0x3b29/Bahnhofs-Steuerung-2000/media/Documentation/Memory_Layout_System.pdf

System

Seite 1

Layout | Legend

Bytes
0 1 2 3 4 5 6 7 | 16 | Total bytes in use
0 | 0 | 1 | 2 | 3 | 4 | 5 | 6 | 7 | 2 | Channels
1 | 8 | 9 | 10 | 11 | 12 | 13 | 14 | 15 | 1 | Force all on
2 | 16 | 17 | 18 | 19 | 20 | 21 | 22 | 23 | 1 | Force all off
3 | 24 | 25 | 26 | 27 | 28 | 29 | 30 | 31 | 1 | Random chaos
4 | 32 | 33 | 34 | 35 | 36 | 37 | 38 | 39 | 1 | Random events
5 | 40 | 41 | 42 | 43 | 44 | 45 | 46 | 47 | 1 | Propagate events
6 | 48 | 49 | 50 | 51 | 52 | 53 | 54 | 55 | 1 | Show options
7 | 56 | 57 | 58 | 59 | 60 | 61 | 62 | 63 | 1 | Show actions
| | | | | | | | | 1 | One based addresses
| | | | | | | | | 1 | Compact display
| | | | | | | | | 1 | Running lights
| | | | | | | | | 2 | High PWM Freq boards
2 | CRC
48 | Free space
