0x3b29/Bahnhofs-Steuerung-2000/media/Circuit/Circuit_V1.2_5V.png

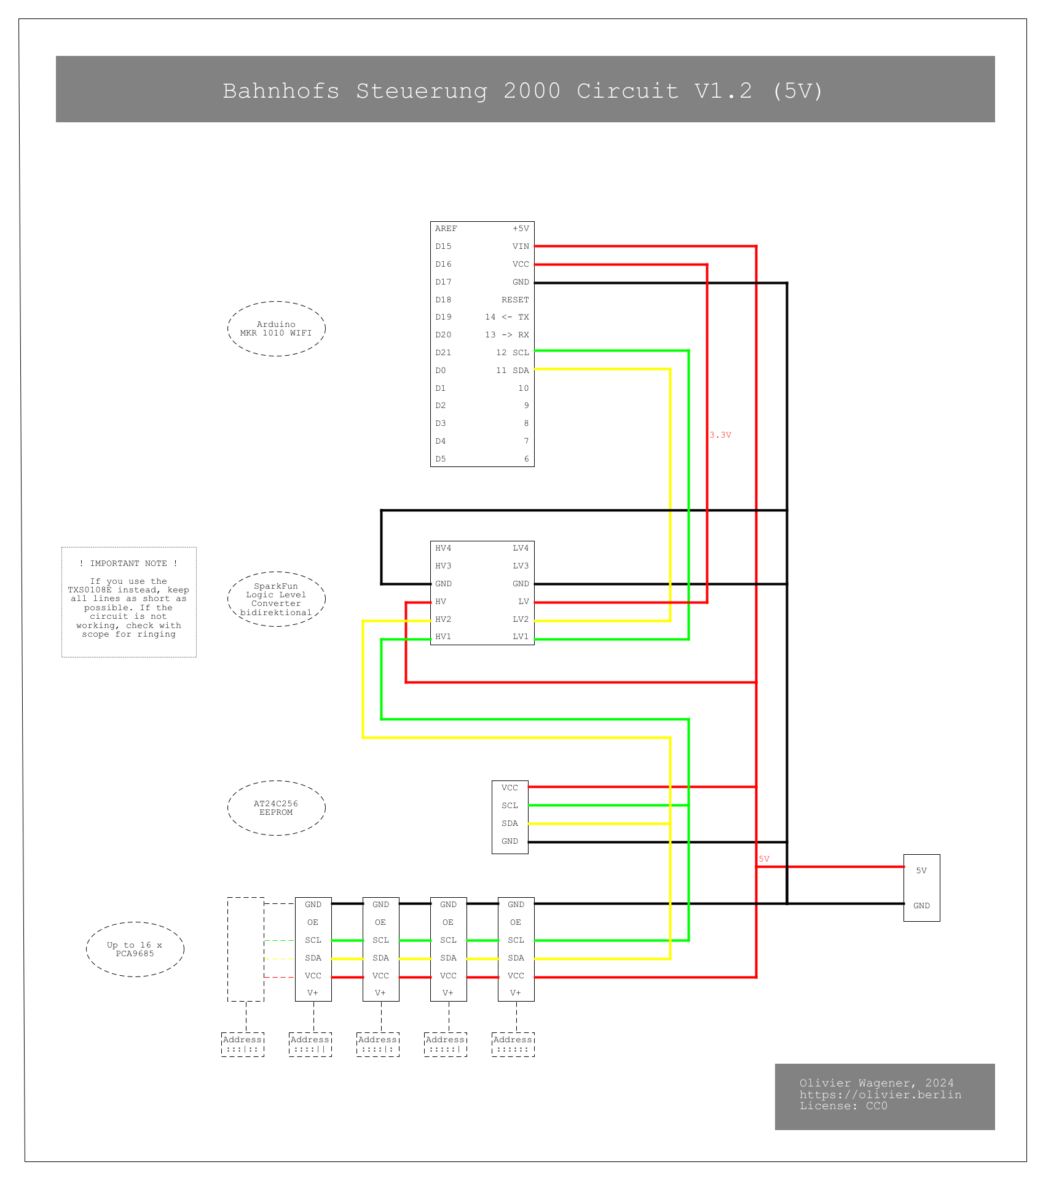
media/Circuit/Circuit_V1.2_5V.png
