0x3b29/Bahnhofs-Steuerung-2000/media/TXS0108E/ringing_start.png

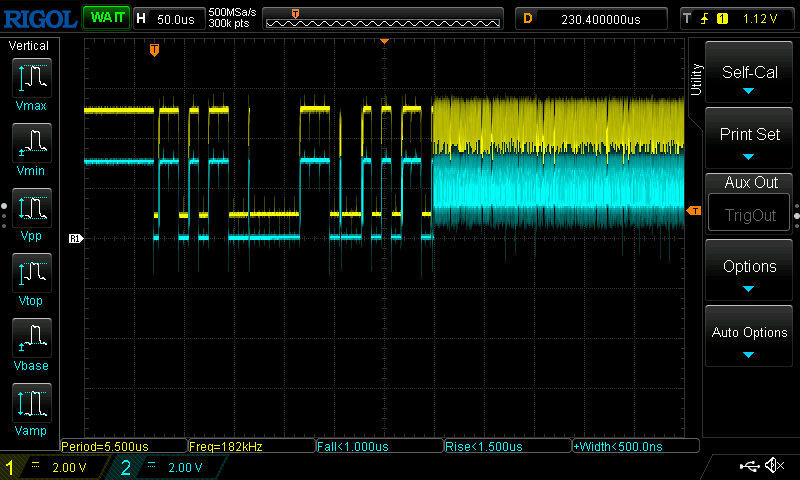
media/TXS0108E/ringing_start.png
