0x3b29/Bahnhofs-Steuerung-2000/media/Circuit/Circuit_V1.2_5V.pdf

# Bahnhofs Steuerung 2000 Circuit V1.2 (5V)

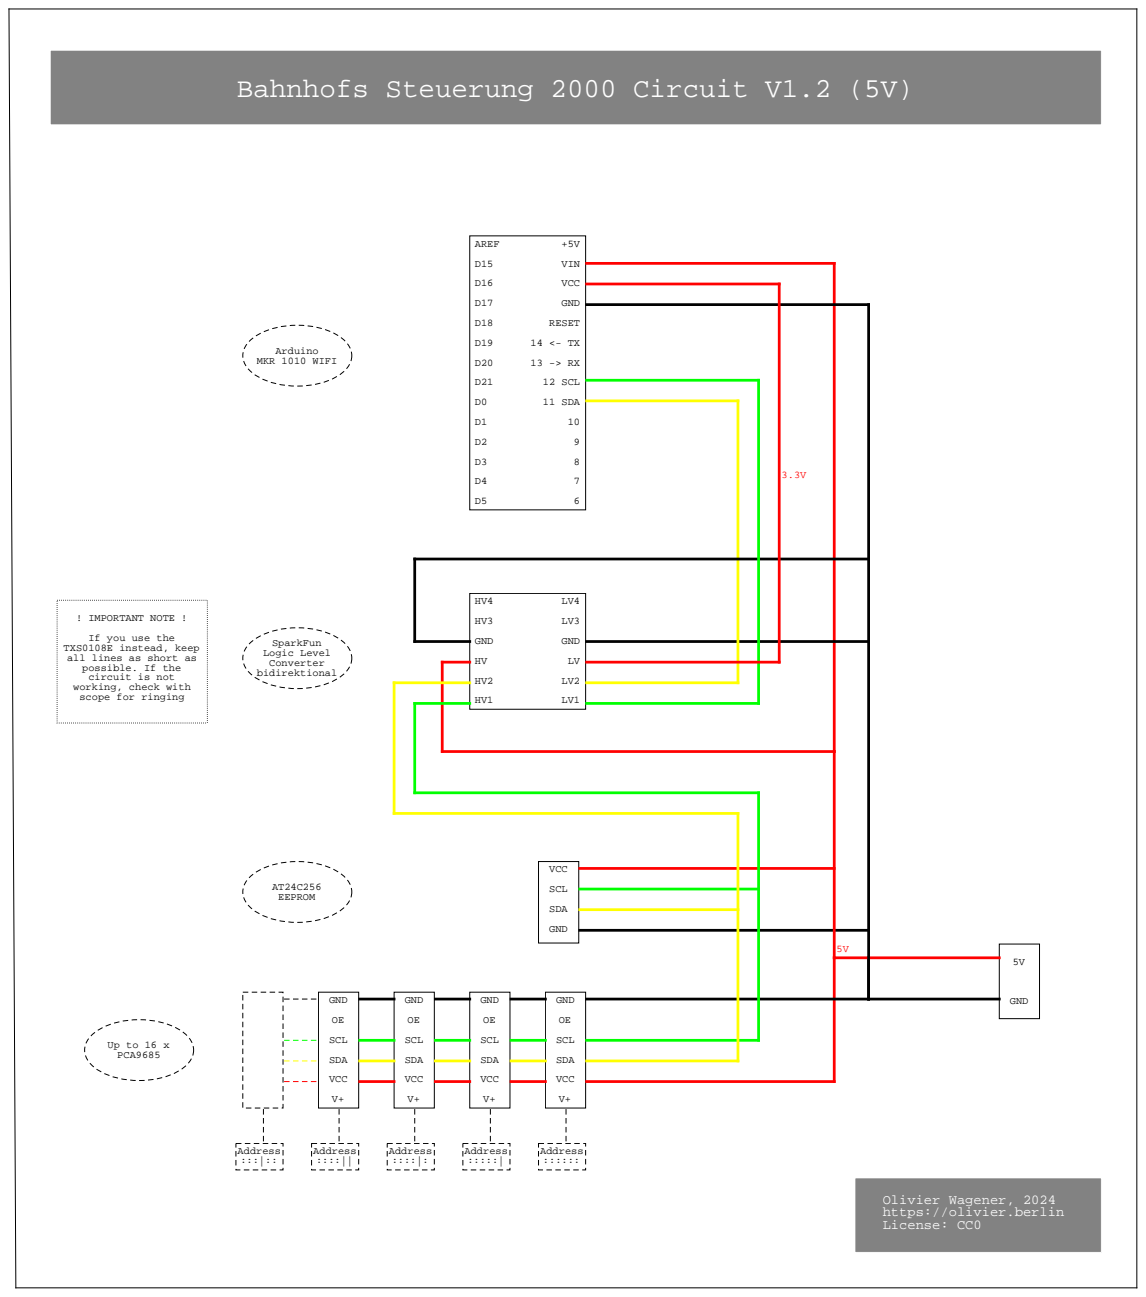
[picture p3: page 1]

! IMPORTANT NOTE !
If you use the
TXS0108E instead, keep
all lines as short as
possible. If the
circuit is not
working, check with
scope for ringing
