0x3b29/Bahnhofs-Steuerung-2000/bahnhofssteuerung2000/i18n/dutch.h

#ifndef dutch_h
#define dutch_h

#define I18N_OPTIONS_CHANNELS "Kanalen"
#define I18N_OPTIONS_SEND "Versturen"
#define I18N_OPTIONS_ONE_BASED_ADDRESSES "Adressering begint bij 1"
#define I18N_OPTIONS_COMPACT_VIEW "Compacte Weergave"
#define I18N_OPTIONS_FORCE_ALL_OFF "Alle kanalen permanent op 0%"
#define I18N_OPTIONS_FORCE_ALL_ON "Alle kanalen permanent op 100%"
#define I18N_OPTIONS_RANDOM_EVENTS "Willekeurige Gebeurtenissen"
#define I18N_OPTIONS_PROPAGATE_EVENTS "Koppelingen Actief"
#define I18N_OPTIONS_CRAZY_BLINK "Geknipper"
#define I18N_OPTIONS_RUNNING_LIGHTS "Lopende Lichtjes"
#define I18N_OPTIONS_SELECT_BOARDS_WITH_HIGH_PWM_FREQ                          \
  "Selecteer welke borden een hoge PWM-frequentie gebruiken"

#define I18N_ACTIONS_EVEN "Even"
#define I18N_ACTIONS_ODD "Oneven"

#define I18N_EDIT_HEADING_BASIC_SETTINGS "Basisinstellingen"
#define I18N_EDIT_HEADING_OPTIONAL_SETTINGS "Optionele Instellingen"
#define I18N_EDIT_HEADING_DISPLAY_SETTINGS "Weergave-instellingen"

#define I18N_EDIT_CHANNEL "Kanaal"
#define I18N_EDIT_EDIT "Bewerken"
#define I18N_EDIT_CHANNEL_NAME "Kanaalnaam"
#define I18N_EDIT_INITIAL_STATE_ON "Is Initiële Staat Aan"
#define I18N_EDIT_BRIGHTNESS "Helderheid"
#define I18N_EDIT_RANDOM_ON "Willekeurig Aanzetten"
#define I18N_EDIT_RANDOM_FREQ "~ Gebeurtenissen/uur"
#define I18N_EDIT_RANDOM_OFF "Willekeurig Uitzetten"
#define I18N_EDIT_LINKED "Is Kanaal Gekoppeld"
#define I18N_EDIT_CONTROLLED_BY_CHANNEL "Gecontroleerd door Kanaal"
#define I18N_EDIT_LINK_DELAY "Heeft Linkvertraging"
#define I18N_EDIT_LINK_DELAY_MS "Linkvertraging (ms)"
#define I18N_EDIT_SHOW_SLIDER "Toon schuifregelaar"
#define I18N_EDIT_DISCARD "Verwerpen"
#define I18N_EDIT_SAVE "Opslaan"

#define I18N_EDIT_MODE_NORMAL "(Normaal Bereik)"
#define I18N_EDIT_MODE_CUSTOM "(Aangepast Bereik)"
#define I18N_EDIT_USE_CUSTOM_RANGE "Gebruikt Aangepast Bereik"
#define I18N_EDIT_CUSTOM_INITIAL_STATE_VALUE_2 "Is Initiële Status Waarde 2"
#define I18N_EDIT_CUSTOM_PWM_VALUE_2 "Waarde 2"
#define I18N_EDIT_CUSTOM_PWM_VALUE_1 "Waarde 1"
#define I18N_EDIT_CUSTOM_PWM_OUTPUT_TEST "Uitvoer Bereik Test"
#define I18N_EDIT_CUSTOM_RANDOM_VALUE_2 "Waarde 2 Willekeurig Instellen"
#define I18N_EDIT_CUSTOM_RANDOM_VALUE_1 "Waarde 1 Willekeurig Instellen"

#define I18N_EDIT_IS_LERPED "Wordt Kanaal Gelerkt"
#define I18N_EDIT_LERP_SPEED "Lerpsnelheid"

#define I18N_CHANNEL_CHANNEL "Kanaal"
#define I18N_CHANNEL_BOARD "Bord"
#define I18N_CHANNEL_PIN "Pin"
#define I18N_CHANNEL_DESCRIPTION "Beschrijving"
#define I18N_CHANNEL_START_STATE "Initiële Staat"
#define I18N_CHANNEL_BRIGHTNESS "Helderheid"
#define I18N_CHANNEL_RANDOMLY_ON "Willekeurig Aanzetten"
#define I18N_CHANNEL_RANDOM_ON_FREQ "~ Gebeurtenissen/uur"
#define I18N_CHANNEL_RANDOMLY_OFF "Willekeurig Uitzetten"
#define I18N_CHANNEL_LINKED "Wordt bestuurd"
#define I18N_CHANNEL_COMMANDED_BY_CHANNEL "↳ Gereguleerd door"
#define I18N_HAS_CHANNEL_LINK_DELAY "Heeft een verbindingsvertraging"
#define I18N_CHANNEL_LINK_DELAY "↳ Verbindingsvertraging (ms)"
#define I18N_IS_CHANNEL_LERPED "Wordt geïnterpoleerd"
#define I18N_CHANNEL_LERP_SPEED "↳ Interpolatiesnelheid"
#define I18N_IS_HIDDEN_IN_COMPACT_VIEW "Is verborgen in compacte weergave"

#define I18N_CHANNEL_ON "Aan"
#define I18N_CHANNEL_OFF "Uit"
#define I18N_CHANNEL_YES "Ja"
#define I18N_CHANNEL_NO "Nee"

#define I18N_CHANNEL_RANGE "Bereik (Waarde 1 - Waarde 2)"

#define I18N_HEADING_OPTIONS "Opties"
#define I18N_HEADING_ACTIONS "Acties"
#define I18N_HEADING_CHANNELS "Kanalen"

#define I18N_WARNING_RECURSION_BEFORE_MAX                                      \
  "Waarschuwing: Een lus of te diepe nesting (meer dan"
#define I18N_WARNING_RECURSION_AFTER_MAX                                       \
  "niveaus) is gedetecteerd in de gekoppelde kanalen. Controleer alle "        \
  "koppelingen "                                                               \
  "op lussen of verhoog de maximale nestdiepte!"

#endif // dutch_h
