0x3b29/Bahnhofs-Steuerung-2000/bahnhofssteuerung2000/i18n/french.h

#ifndef french_h
#define french_h

#define I18N_OPTIONS_CHANNELS "Canaux"
#define I18N_OPTIONS_SEND "Envoyer"
#define I18N_OPTIONS_ONE_BASED_ADDRESSES "L'adressage commence à 1"
#define I18N_OPTIONS_COMPACT_VIEW "Vue Compacte"
#define I18N_OPTIONS_FORCE_ALL_OFF "Tous les canaux en permanence à 0%"
#define I18N_OPTIONS_FORCE_ALL_ON "Tous les canaux en permanence à 100%"
#define I18N_OPTIONS_RANDOM_EVENTS "Événements Aléatoires"
#define I18N_OPTIONS_PROPAGATE_EVENTS "Liaisons Actives"
#define I18N_OPTIONS_CRAZY_BLINK "Clignotement Fou"
#define I18N_OPTIONS_RUNNING_LIGHTS "Lumières en Mouvement"
#define I18N_OPTIONS_SELECT_BOARDS_WITH_HIGH_PWM_FREQ                          \
  "Sélectionne quelles cartes utilisent une fréquence PWM élevée"

#define I18N_ACTIONS_EVEN "Pair"
#define I18N_ACTIONS_ODD "Impair"

#define I18N_EDIT_HEADING_BASIC_SETTINGS "Paramètres de Base"
#define I18N_EDIT_HEADING_OPTIONAL_SETTINGS "Paramètres Optionnels"
#define I18N_EDIT_HEADING_DISPLAY_SETTINGS "Paramètres d'Affichage"

#define I18N_EDIT_CHANNEL "Canal"
#define I18N_EDIT_EDIT "Éditer"
#define I18N_EDIT_CHANNEL_NAME "Nom du Canal"
#define I18N_EDIT_INITIAL_STATE_ON "Est État Initial Activé"
#define I18N_EDIT_BRIGHTNESS "Luminosité"
#define I18N_EDIT_RANDOM_ON "Allumage Aléatoire"
#define I18N_EDIT_RANDOM_FREQ "~ Événements/h"
#define I18N_EDIT_RANDOM_OFF "Extinction Aléatoire"
#define I18N_EDIT_LINKED "Est Canal Lié"
#define I18N_EDIT_CONTROLLED_BY_CHANNEL "Contrôlé par Canal"
#define I18N_EDIT_LINK_DELAY "A un délai de liaison"
#define I18N_EDIT_LINK_DELAY_MS "Délai de liaison (ms)"
#define I18N_EDIT_SHOW_SLIDER "Afficher contrôle du curseur"
#define I18N_EDIT_DISCARD "Annuler"
#define I18N_EDIT_SAVE "Sauvegarder"

#define I18N_EDIT_MODE_NORMAL "(Plage Normale)"
#define I18N_EDIT_MODE_CUSTOM "(Plage Personnalisée)"
#define I18N_EDIT_USE_CUSTOM_RANGE "Utilise une Plage Personnalisée"
#define I18N_EDIT_CUSTOM_INITIAL_STATE_VALUE_2 "L'État Initial est Valeur 2"
#define I18N_EDIT_CUSTOM_PWM_VALUE_2 "Valeur 2"
#define I18N_EDIT_CUSTOM_PWM_VALUE_1 "Valeur 1"
#define I18N_EDIT_CUSTOM_PWM_OUTPUT_TEST "Test de Plage de Sortie"
#define I18N_EDIT_CUSTOM_RANDOM_VALUE_2 "Valeur 2 Définie Aléatoirement"
#define I18N_EDIT_CUSTOM_RANDOM_VALUE_1 "Valeur 1 Définie Aléatoirement"

#define I18N_EDIT_IS_LERPED "Le Canal est Interpolé"
#define I18N_EDIT_LERP_SPEED "Vitesse d'Interpolation"

#define I18N_CHANNEL_CHANNEL "Canal"
#define I18N_CHANNEL_BOARD "Carte"
#define I18N_CHANNEL_PIN "Pin"
#define I18N_CHANNEL_DESCRIPTION "Description"
#define I18N_CHANNEL_START_STATE "État Initial"
#define I18N_CHANNEL_BRIGHTNESS "Luminosité"
#define I18N_CHANNEL_RANDOMLY_ON "Allumage Aléatoire"
#define I18N_CHANNEL_RANDOM_ON_FREQ "↳ ~ Événements/h"
#define I18N_CHANNEL_RANDOMLY_OFF "Extinction Aléatoire"
#define I18N_CHANNEL_LINKED "Est contrôlé par un autre"
#define I18N_CHANNEL_COMMANDED_BY_CHANNEL "↳ Contrôlé par"
#define I18N_HAS_CHANNEL_LINK_DELAY "A un délai de liaison"
#define I18N_CHANNEL_LINK_DELAY "↳ Délai de liaison (ms)"
#define I18N_IS_CHANNEL_LERPED "Est interpolé"
#define I18N_CHANNEL_LERP_SPEED "↳ Vitesse d'interpolation"
#define I18N_IS_HIDDEN_IN_COMPACT_VIEW "Est masqué en vue compacte"

#define I18N_CHANNEL_ON "Activé"
#define I18N_CHANNEL_OFF "Désactivé"
#define I18N_CHANNEL_YES "Oui"
#define I18N_CHANNEL_NO "Non"

#define I18N_CHANNEL_RANGE "Plage (Valeur 1 - Valeur 2)"

#define I18N_HEADING_OPTIONS "Options"
#define I18N_HEADING_ACTIONS "Actions"
#define I18N_HEADING_CHANNELS "Canaux"

#define I18N_WARNING_RECURSION_BEFORE_MAX                                      \
  "Avertissement : Une boucle ou un enchevêtrement trop profond (plus de"
#define I18N_WARNING_RECURSION_AFTER_MAX                                             \
  "niveaux) a été détecté dans les canaux liés. Veuillez vérifier toutes les " \
  "liaisons "                                                                        \
  "pour les boucles ou augmenter la profondeur maximale d'enchevêtrement!"

#endif // french_h
