0x3b29/Bahnhofs-Steuerung-2000/bahnhofssteuerung2000/i18n/german.h

#ifndef german_h
#define german_h

#define I18N_OPTIONS_CHANNELS "Kanäle"
#define I18N_OPTIONS_SEND "Senden"
#define I18N_OPTIONS_ONE_BASED_ADDRESSES "Adressierung startet bei 1"
#define I18N_OPTIONS_COMPACT_VIEW "Kompakte Übersicht"
#define I18N_OPTIONS_FORCE_ALL_OFF "Alle Kanäle dauerhaft auf 0 %"
#define I18N_OPTIONS_FORCE_ALL_ON "Alle Kanäle dauerhaft auf 100 %"
#define I18N_OPTIONS_RANDOM_EVENTS "Zufällige Ereignisse"
#define I18N_OPTIONS_PROPAGATE_EVENTS "Verknüpfungen aktiv"
#define I18N_OPTIONS_CRAZY_BLINK "Verrücktes Blinken"
#define I18N_OPTIONS_RUNNING_LIGHTS "Lauf Licht"
#define I18N_OPTIONS_SELECT_BOARDS_WITH_HIGH_PWM_FREQ                          \
  "Wähle aus welche Platinen die hohe PWM Frequenz nutzen"

#define I18N_ACTIONS_EVEN "Gerade"
#define I18N_ACTIONS_ODD "Ungerade"

#define I18N_EDIT_HEADING_BASIC_SETTINGS "Grundeinstellungen"
#define I18N_EDIT_HEADING_OPTIONAL_SETTINGS "Optionale Einstellungen"
#define I18N_EDIT_HEADING_DISPLAY_SETTINGS "Anzeigeeinstellungen"

#define I18N_EDIT_CHANNEL "Kanal"
#define I18N_EDIT_EDIT "Bearbeiten"
#define I18N_EDIT_CHANNEL_NAME "Kanalname"
#define I18N_EDIT_INITIAL_STATE_ON "Ist Startzustand An"
#define I18N_EDIT_BRIGHTNESS "Helligkeit"
#define I18N_EDIT_RANDOM_ON "Zufällig Einschalten"
#define I18N_EDIT_RANDOM_FREQ "~ Zufälle/h"
#define I18N_EDIT_RANDOM_OFF "Zufällig Ausschalten"
#define I18N_EDIT_LINKED "Ist Kanal Verknüpft"
#define I18N_EDIT_CONTROLLED_BY_CHANNEL "Gesteuert von Kanal"
#define I18N_EDIT_LINK_DELAY "Hat Verknüpfungsverzögerung"
#define I18N_EDIT_LINK_DELAY_MS "Verknüpfungsverzögerung (ms)"
#define I18N_EDIT_SHOW_SLIDER "Zeige Schieberegler"
#define I18N_EDIT_DISCARD "Verwerfen"
#define I18N_EDIT_SAVE "Speichern"

#define I18N_EDIT_MODE_NORMAL "(Normaler Bereich)"
#define I18N_EDIT_MODE_CUSTOM "(Benutzerdefinierter Bereich)"
#define I18N_EDIT_USE_CUSTOM_RANGE "Verwendet Benutzerdefinierten Bereich"
#define I18N_EDIT_CUSTOM_INITIAL_STATE_VALUE_2 "Ist Anfangszustand Wert 2"
#define I18N_EDIT_CUSTOM_PWM_VALUE_2 "Wert 2"
#define I18N_EDIT_CUSTOM_PWM_VALUE_1 "Wert 1"
#define I18N_EDIT_CUSTOM_PWM_OUTPUT_TEST "Ausgabebereichstest"
#define I18N_EDIT_CUSTOM_RANDOM_VALUE_2 "Wert 2 zufällig setzen"
#define I18N_EDIT_CUSTOM_RANDOM_VALUE_1 "Wert 1 zufällig setzen"

#define I18N_EDIT_IS_LERPED "Kanal wird Interpoliert"
#define I18N_EDIT_LERP_SPEED "Interpolationsgeschwindigkeit"

#define I18N_CHANNEL_CHANNEL "Kanal"
#define I18N_CHANNEL_BOARD "Platine"
#define I18N_CHANNEL_PIN "Pin"
#define I18N_CHANNEL_DESCRIPTION "Beschreibung"
#define I18N_CHANNEL_START_STATE "Startzustand"
#define I18N_CHANNEL_BRIGHTNESS "Helligkeit"
#define I18N_CHANNEL_RANDOMLY_ON "Zufällig Einschalten"
#define I18N_CHANNEL_RANDOM_ON_FREQ "↳ ~ Zufälle/h"
#define I18N_CHANNEL_RANDOMLY_OFF "Zufällig Ausschalten"
#define I18N_CHANNEL_LINKED "Wird gesteuert"
#define I18N_CHANNEL_COMMANDED_BY_CHANNEL "↳ Gesteuert von"
#define I18N_HAS_CHANNEL_LINK_DELAY "Hat eine Verknüpfungsverzögerung"
#define I18N_CHANNEL_LINK_DELAY "↳ Verknüpfungsverzögerung (ms)"
#define I18N_IS_CHANNEL_LERPED "Wird interpoliert"
#define I18N_CHANNEL_LERP_SPEED "↳ Interpolationsgeschwindigkeit"
#define I18N_IS_HIDDEN_IN_COMPACT_VIEW "Ist in der kompakten Ansicht ausgeblendet"

#define I18N_CHANNEL_ON "An"
#define I18N_CHANNEL_OFF "Aus"
#define I18N_CHANNEL_YES "Ja"
#define I18N_CHANNEL_NO "Nein"

#define I18N_CHANNEL_RANGE "Bereich (Wert 1 - Wert 2)"

#define I18N_HEADING_OPTIONS "Optionen"
#define I18N_HEADING_ACTIONS "Aktionen"
#define I18N_HEADING_CHANNELS "Kanäle"

#define I18N_WARNING_RECURSION_BEFORE_MAX                                      \
  "Achtung: Eine Schleife oder zu eine zu tiefe Verschachtelung (mehr als"
#define I18N_WARNING_RECURSION_AFTER_MAX                                         \
  "Ebenen) wurde in den verknüpften Kanälen entdeckt. Bitte überprüfe alle " \
  "Verknüpfungen auf Schleifen oder erhöhe die maximale "                      \
  "Verschachtelungstiefe!"
#endif // german
