0x3b29/Bahnhofs-Steuerung-2000/bahnhofssteuerung2000/i18n/luxembourgish.h

#ifndef luxembourgish_h
#define luxembourgish_h

#define I18N_OPTIONS_CHANNELS "Kanäl"
#define I18N_OPTIONS_SEND "Schécken"
#define I18N_OPTIONS_ONE_BASED_ADDRESSES "Adresséierung fänkt bei 1 un"
#define I18N_OPTIONS_COMPACT_VIEW "Kompakt Vue"
#define I18N_OPTIONS_FORCE_ALL_OFF "All Kanäl permanent op 0%"
#define I18N_OPTIONS_FORCE_ALL_ON "All Kanäl permanent op 100%"
#define I18N_OPTIONS_RANDOM_EVENTS "Zoufälleg Un/Aus"
#define I18N_OPTIONS_PROPAGATE_EVENTS "Verbindungen aktiv"
#define I18N_OPTIONS_CRAZY_BLINK "Verréckt Blénken"
#define I18N_OPTIONS_RUNNING_LIGHTS "Laaf-Liichter"
#define I18N_OPTIONS_SELECT_BOARDS_WITH_HIGH_PWM_FREQ                          \
  "Wiel aus weieng Platinnen eng héich PWM Frequenz benotzen"

#define I18N_ACTIONS_EVEN "Gerued"
#define I18N_ACTIONS_ODD "Ongerued"

#define I18N_EDIT_HEADING_BASIC_SETTINGS "Grondleeënd Astellungen"
#define I18N_EDIT_HEADING_OPTIONAL_SETTINGS "Optional Astellungen"
#define I18N_EDIT_HEADING_DISPLAY_SETTINGS "Uweis Astellungen"

#define I18N_EDIT_CHANNEL "Kanal"
#define I18N_EDIT_EDIT "Änneren"
#define I18N_EDIT_CHANNEL_NAME "Kanalsnumm"
#define I18N_EDIT_INITIAL_STATE_ON "Ass Ufankszoustand Un"
#define I18N_EDIT_BRIGHTNESS "Hellegkeet"
#define I18N_EDIT_RANDOM_ON "Zoufälleg Un"
#define I18N_EDIT_RANDOM_FREQ "~ Un/Aus pro Stonn"
#define I18N_EDIT_RANDOM_OFF "Zoufälleg Aus"
#define I18N_EDIT_LINKED "Ass Kanal Verbonnen"
#define I18N_EDIT_CONTROLLED_BY_CHANNEL "Gesteiert vu Kanal"
#define I18N_EDIT_LINK_DELAY "Huet Verzögerung an der Verbingung"
#define I18N_EDIT_LINK_DELAY_MS "Verbingungsverzögerung (ms)"
#define I18N_EDIT_SHOW_SLIDER "Weis Rutschregeler"
#define I18N_EDIT_DISCARD "Ofbriechen"
#define I18N_EDIT_SAVE "Späicheren"

#define I18N_EDIT_MODE_NORMAL "(Normale Beräich)"
#define I18N_EDIT_MODE_CUSTOM "(Benotzerdefinéierte Beräich)"
#define I18N_EDIT_USE_CUSTOM_RANGE "Benotzt Benotzerdefinéierte Beräich"
#define I18N_EDIT_CUSTOM_INITIAL_STATE_VALUE_2 "Ass Ufankszoustand den Wäert 2"
#define I18N_EDIT_CUSTOM_PWM_VALUE_2 "Wäert 2"
#define I18N_EDIT_CUSTOM_PWM_VALUE_1 "Wäert 1"
#define I18N_EDIT_CUSTOM_PWM_OUTPUT_TEST "Test Beräich"
#define I18N_EDIT_CUSTOM_RANDOM_VALUE_2 "Wäert 2 zoufälleg setzen"
#define I18N_EDIT_CUSTOM_RANDOM_VALUE_1 "Wäert 1 zoufälleg setzen"

#define I18N_EDIT_IS_LERPED "Kanal gett Interpoliert"
#define I18N_EDIT_LERP_SPEED "Interpolatiounsvitesse"

#define I18N_CHANNEL_CHANNEL "Kanal"
#define I18N_CHANNEL_BOARD "Platinn"
#define I18N_CHANNEL_PIN "Pin"
#define I18N_CHANNEL_DESCRIPTION "Beschreiwung"
#define I18N_CHANNEL_START_STATE "Ufankszoustand"
#define I18N_CHANNEL_BRIGHTNESS "Hellegkeet"
#define I18N_CHANNEL_RANDOMLY_ON "Zoufälleg Un"
#define I18N_CHANNEL_RANDOM_ON_FREQ "~ Un/Aus pro Stonn"
#define I18N_CHANNEL_RANDOMLY_OFF "Zoufälleg Aus"
#define I18N_CHANNEL_LINKED "Gëtt Gesteiert"
#define I18N_CHANNEL_COMMANDED_BY_CHANNEL "↳ Gesteiert vu"
#define I18N_HAS_CHANNEL_LINK_DELAY "Huet eng Verbindungsverzögerung"
#define I18N_CHANNEL_LINK_DELAY "↳ Verbindungsverzögerung (ms)"
#define I18N_IS_CHANNEL_LERPED "Gëtt interpoléiert"
#define I18N_CHANNEL_LERP_SPEED "↳ Interpolatiounsgeschwindegkeet"
#define I18N_IS_HIDDEN_IN_COMPACT_VIEW "Ass an der kompakter Vue verstoppt"

#define I18N_CHANNEL_ON "Un"
#define I18N_CHANNEL_OFF "Aus"
#define I18N_CHANNEL_YES "Jo"
#define I18N_CHANNEL_NO "Nee"

#define I18N_CHANNEL_RANGE "Beräich (Wäert 1 - Wäert 2)"

#define I18N_HEADING_OPTIONS "Optiounen"
#define I18N_HEADING_ACTIONS "Aktiounen"
#define I18N_HEADING_CHANNELS "Kanäl"

#define I18N_WARNING_RECURSION_BEFORE_MAX                                      \
  "Warnung: Eng Schleef oder ze déif Verschachtlung (méi wéi"
#define I18N_WARNING_RECURSION_AFTER_MAX                                       \
  "Niveauen) gouf an de verbonne Kanäl entdeckt. Iwwerpréift w.e.g all "     \
  "Verbindungen "                                                              \
  "op Schleefen oder erhéicht déi maximal Verschachtlungsdéift!"

#endif // luxembourgish_h
