0x3b29/Bahnhofs-Steuerung-2000/bahnhofssteuerung2000/helpers.h

#ifndef helpers_h
#define helpers_h

#include "bahnhofssteuerung2000.h"
#include <Arduino.h>

uint8_t getBoardIndexForChannel(uint16_t channel);
uint8_t getBoardAddressForChannel(uint16_t channel);
uint8_t getBoardSubAddressForChannel(uint16_t channel);

float mapf(float x, float in_min, float in_max, float out_min, float out_max);

void floatToBuffer(float value, char *buffer, size_t bufferSize, uint8_t precision);

#endif // helpers_h
