0x3b29/Bahnhofs-Steuerung-2000/bahnhofssteuerung2000/symbols.h

#ifndef symbols_h
#define symbols_h

#define SYMBOL_EDIT_CHANNEL "🖊"

#define SYMBOL_TURN_LIGHT_ON "⛭"
#define SYMBOL_TURN_LIGHT_ON_CLASS "text-warning"

#define SYMBOL_TURN_LIGHT_OFF "⛭"
#define SYMBOL_TURN_LIGHT_OFF_CLASS ""

#define SYMBOL_SET_VALUE_1 "◄"
#define SYMBOL_SET_VALUE_1_CLASS "text-primary"

#define SYMBOL_SET_VALUE_2 "►"
#define SYMBOL_SET_VALUE_2_CLASS "text-primary"


#endif // symbols_h
