0x3b29/Bahnhofs-Steuerung-2000/bahnhofssteuerung2000/_example_arduino_secrets.h

// Copy this file, rename to arduino_secrets.h and fill in your wifi
// credentials. Please also note that the "" are nessesary.
#define SECRET_SSID "Your_WiFi_Name"
#define SECRET_PASS "Your_WiFi_Password"
