0x3b29/Bahnhofs-Steuerung-2000/(commit log)

2024-01-20 feat: add the functionality for random events to show on leds
2024-01-20 chore: remove unnessesary prints
2024-01-20 fix: reimplement ignore modification button
    [main.ino]
2024-01-20 feat: speed up page rendering by removing as many print statements as possible
2024-01-20 fix: remove newline that broke edit button
    [main.ino]
2024-01-22 chore: rephrase labels to avoid confusion
    [main.ino]
2024-01-22 fix: increase buffer size of linked channel to avoid cutting off after one number
    [main.ino]
2024-01-22 feat: add fake favIcon to head to avoid favicon requests putting unnessesary straing on the arduino
    [main.ino]
2024-01-23 feat: add toggle to prevent random events from happening to facilitate configuration
    [eeprom.h, main.h, main.ino, render.cpp, render.h]
2024-01-23 chore: remove unused spi include
2024-01-23 chore: rename PAGE_SIZE to EEPROM_PAGE_SIZE to avoid OTA naming clash
    [eeprom.cpp, eeprom.h, main.ino]
2024-01-23 feat: add buttons to compact design to allow to get to modification pane
2024-01-23 feat: add another shortcut to turn all leds to 25%
    [main.ino, render.cpp]
2024-01-25 fix: use correct strings for stating if events are enabled or not
    [render.cpp]
2024-01-25 feat: add rendering of hr to channel rendering to have print calls and increase speed
2024-01-25 fix: resolve 100% option not rendering due to sprintf breaking
    [render.cpp]
2024-01-25 feat: display loop error also after ajax requests e.g. turn on / off, change brightness
    [main.ino, render.cpp]
2024-01-25 fix: resolve bug that caused linked lights to get parents brightness and not own brightness
    [main.ino]
2024-01-25 feat: store the state of the actions and options toggle buttons in eeprom and load them back
2024-01-25 fix: resolve strange bug where removing text-muted class was not enough to get the original text color back
    [render.cpp]
2024-01-27 fix: add % back to action buttons
    [render.cpp]
2024-01-27 fix: move generall settings of one based addresses and compact diplay to their appropriate addresses
    [eeprom.h]
2024-01-27 fix: resolve minor style hickup
    [render.cpp]
2024-01-30 chore: add graphics of circuit for easier assembly
2024-01-31 chore: move all led controlling logic into seperate class
2024-01-31 chore: move random chaos into seperate function instead of handling that case somewhere
2024-01-31 fix: make binaryCounter bigger than bool to avoid reaching max early
    [led_controller.h]
2024-01-31 chore: take care of edge case when more than 16 boards are in use
2024-01-31 chore: update README on board addressing
2024-02-10 chore: fix some of the luxembourgish translation
    [luxembourgish.h]
2024-02-10 chore: render more buttons to give access to more low end brightness levels
2024-02-11 fix: resolve finding substrings in strings when searching for post args
    [server_controller.cpp]
2024-02-20 chore: save changes to the README to clearly state the amount of usable LEDs with the Arduino MRK WiFi 1010
2024-02-20 chore: updated schematics to display project name
2024-04-22 feat: center values in detailed view for small devices
2024-07-05 fix: remove OTA which caused WifiNINA to lock up on reloads
    [main.ino]
2024-07-05 fix: resolve bad int type for page which caused overflow after page 255
    [eeprom.cpp, eeprom.h]
2024-07-05 chore: add a check to limit read channels to max channels to avoid reads in unallocated memory
    [state_manager.cpp]
2024-07-05 chore: use snprintf instead of sprintf to avoid writing more than buffer size, bundle client.println into function to facilitate debugging
    [eeprom.cpp, render.cpp, render.h]
2024-07-05 chore: increase limit for PWM boards to 16. A few more are still possible but untested
2024-07-05 fix: add back old algorithm to get client request to avoid Safari request data getting lost
    [server_controller.cpp, server_controller.h]
2024-07-07 chore: add visual memory layout documentation
    [Memory_Layout.ods]
2024-07-09 chore: break up renderer into smaller files and move edit to seperate page to get rid of form tags to avoid browser resend warnings
    [render.cpp, render.h, render_edit_channel.cpp, render_top.cpp, server_controller.cpp, server_controller.h, state_manager.cpp]
2024-07-10 chore: change order of buttons to have On button to the right
2024-07-14 chore: add many backend changes to avoid moving servos out of their defined range
    [channel_controller.cpp, channel_controller.h, main.ino, render_top.cpp, server_controller.cpp, server_controller.h]
2024-10-28 feat: add the ability to set different PWM frequencies for different boards to allow for analog servos and non flickering leds
    [Memory_Layout.ods]
2024-10-29 chore: remove old and broken reset eeprom code
    [render_top.cpp, server_controller.cpp]
2024-10-30 fix: resolve using bad value2 on random events
    [channel_controller.cpp]
2024-10-30 fix: resolve backwards mapping in setAllChannels by using mapf function
    [channel_controller.cpp]
2024-10-30 fix: resolve remaining issues with additional buttons with servos
    [channel_controller.cpp]
2024-10-30 chore: switch value1 and value2 in code for clarity such that value 2 is right and brighter/bigger and value1 is left and smaller or 0
2024-10-30 fix: resolve test slider not showing correct percentage when value1 or value2 modified
    [render_edit_channel.cpp]
2024-11-01 chore: add .arduino_secrets.h to gitignore to avoid accidential upload
2024-11-12 chore: add note about quotes to arduino secrets example file
2024-11-20 chore: add support for saving and reading floats from eeprom
    [Memory_Layout.ods]
2024-11-25 fix: resolve bug that causes wrong value to be used as off position due to missing variable initialisation
    [server_controller.cpp]
2024-11-25 doc: udate memory layout spreadsheet
    [Memory_Layout.ods]
2024-12-05 chore: rename active channels to currently lerping channels
2024-12-09 chore: remove forgotten serial print
2024-12-09 chore: fix speed calculation for lerp
    [channel_controller.cpp, channel_controller_lerp.cpp, server_controller.cpp]
2024-12-09 chore: add collapsable delay field to frontend
    [Memory_Layout.ods]
2024-12-22 chore: restructure settings and fix float rendering bug
    [channel_controller.cpp, channel_controller.h, channel_controller_lerp.cpp, dutch.h, english.h, french.h, german.h, helpers.cpp]
2024-12-27 chore: move render expanded channel name and buttons into shared file
2025-01-09 fix: set default language to English again
    [bahnhofssteuerung2000.h]
2025-01-09 fix: resolve missing I18N for unnamed channels in compact view
    [render_display_channel_compact.cpp]
2026-01-27 feat: alter font and stylesheet loading to be served by the Arduino itselt, to remove the necessity for an internet connection
